PascalBilger/Twin-Io/Electronics/2024-03-01_Twin_Io.brd

## EAGLE design Electronics/2024-03-01_Twin_Io.brd (2024-03-18)

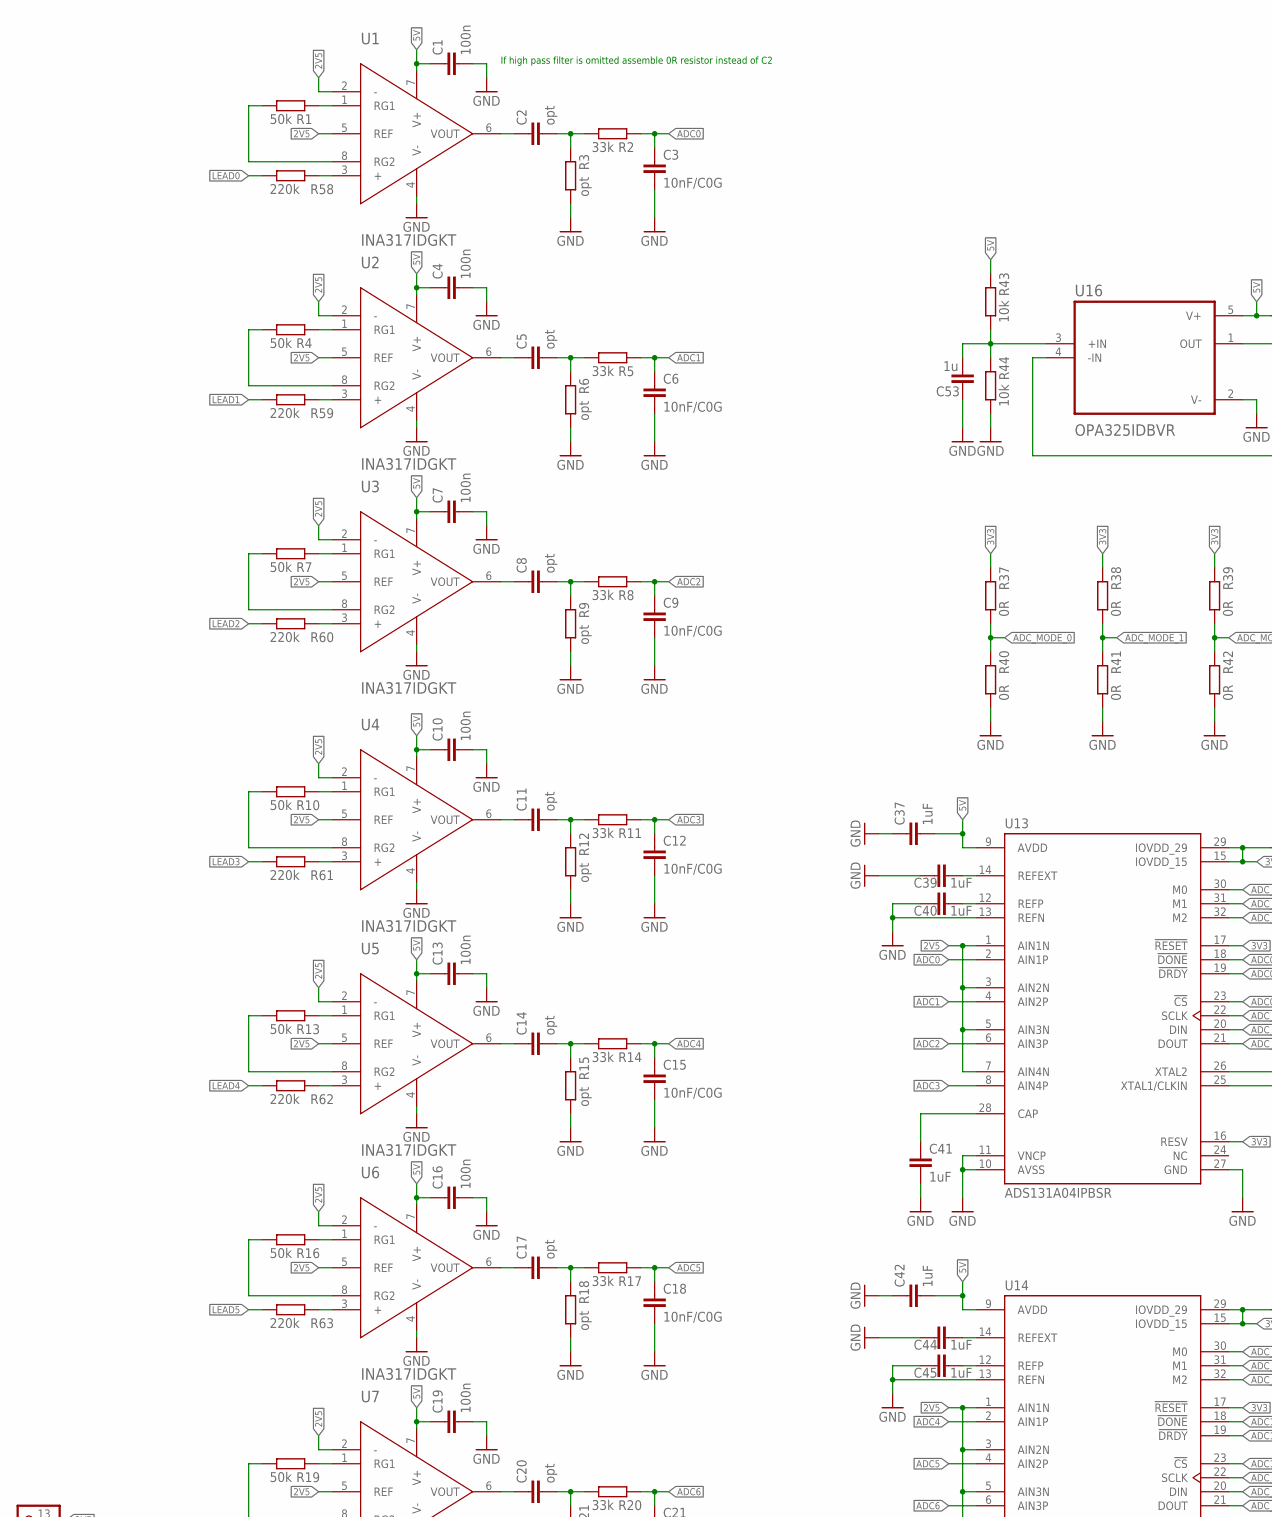
[picture p1: schematic 2024-03-01_Twin_Io.sch, part in row 1, column 1]

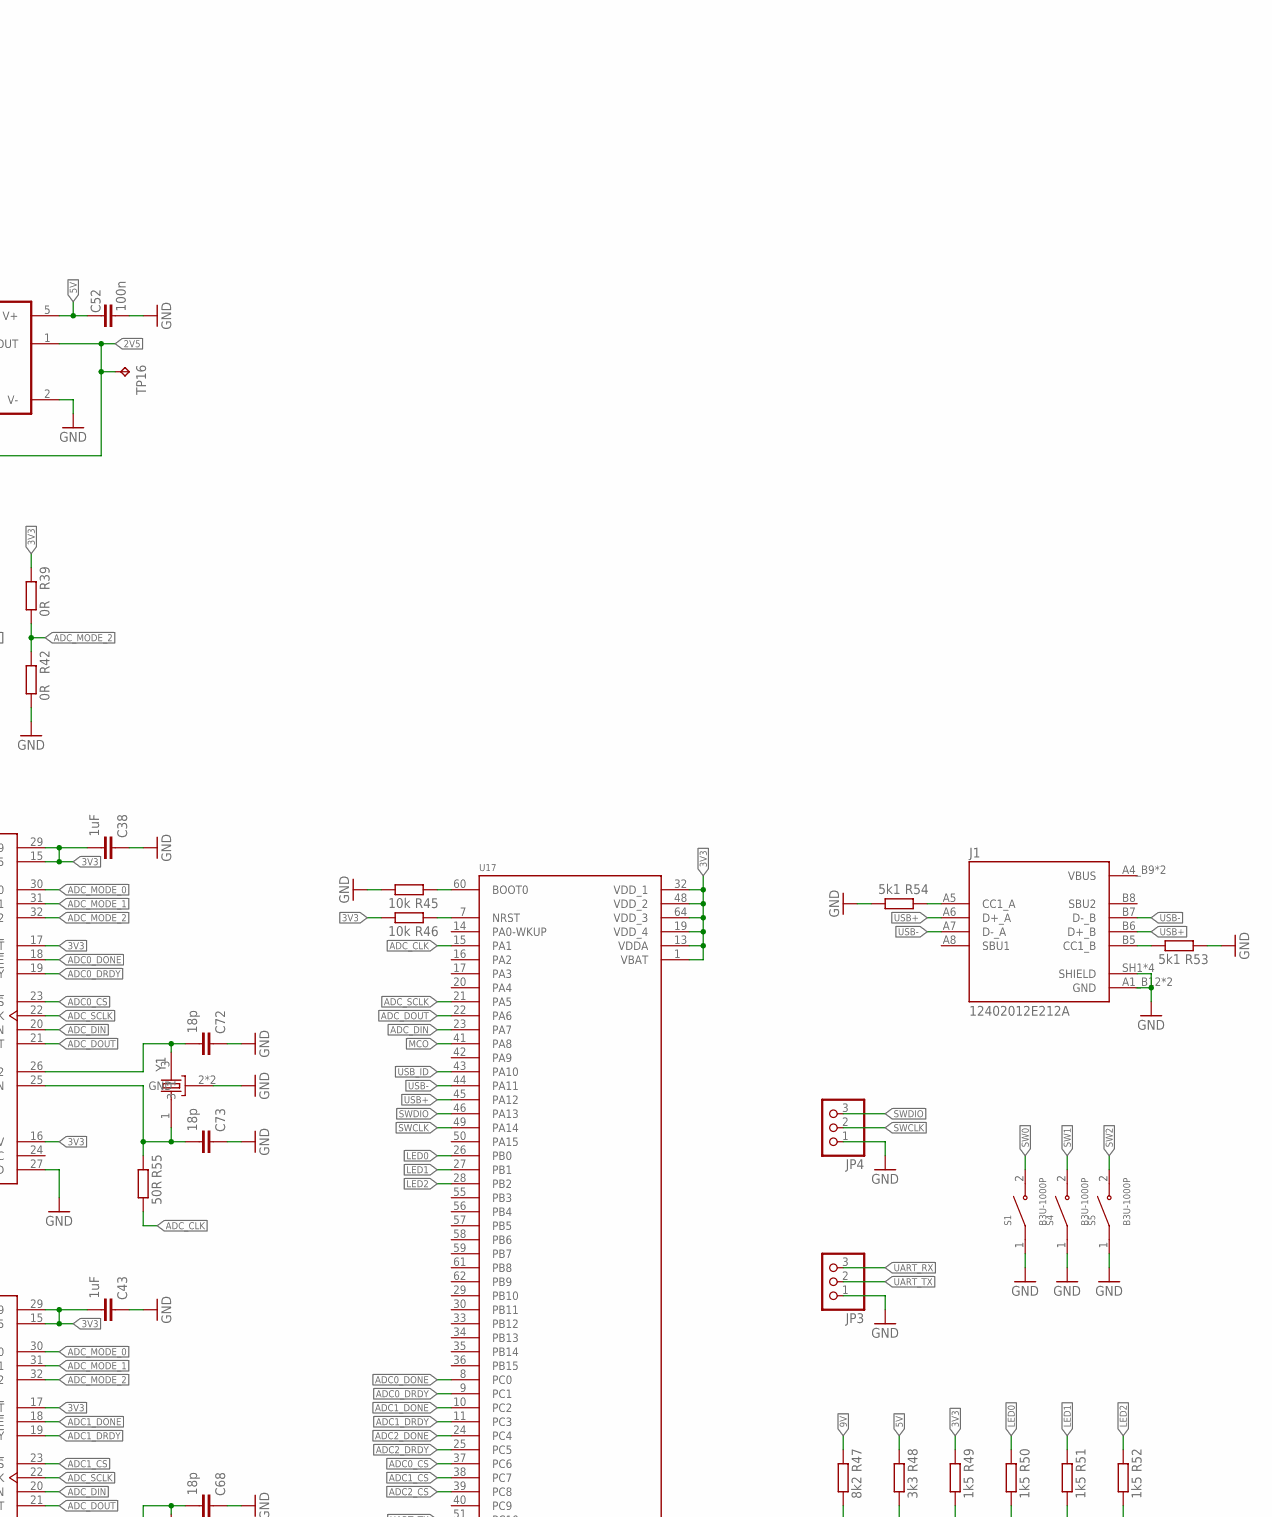
[picture p2: schematic 2024-03-01_Twin_Io.sch, part in row 1, column 2]

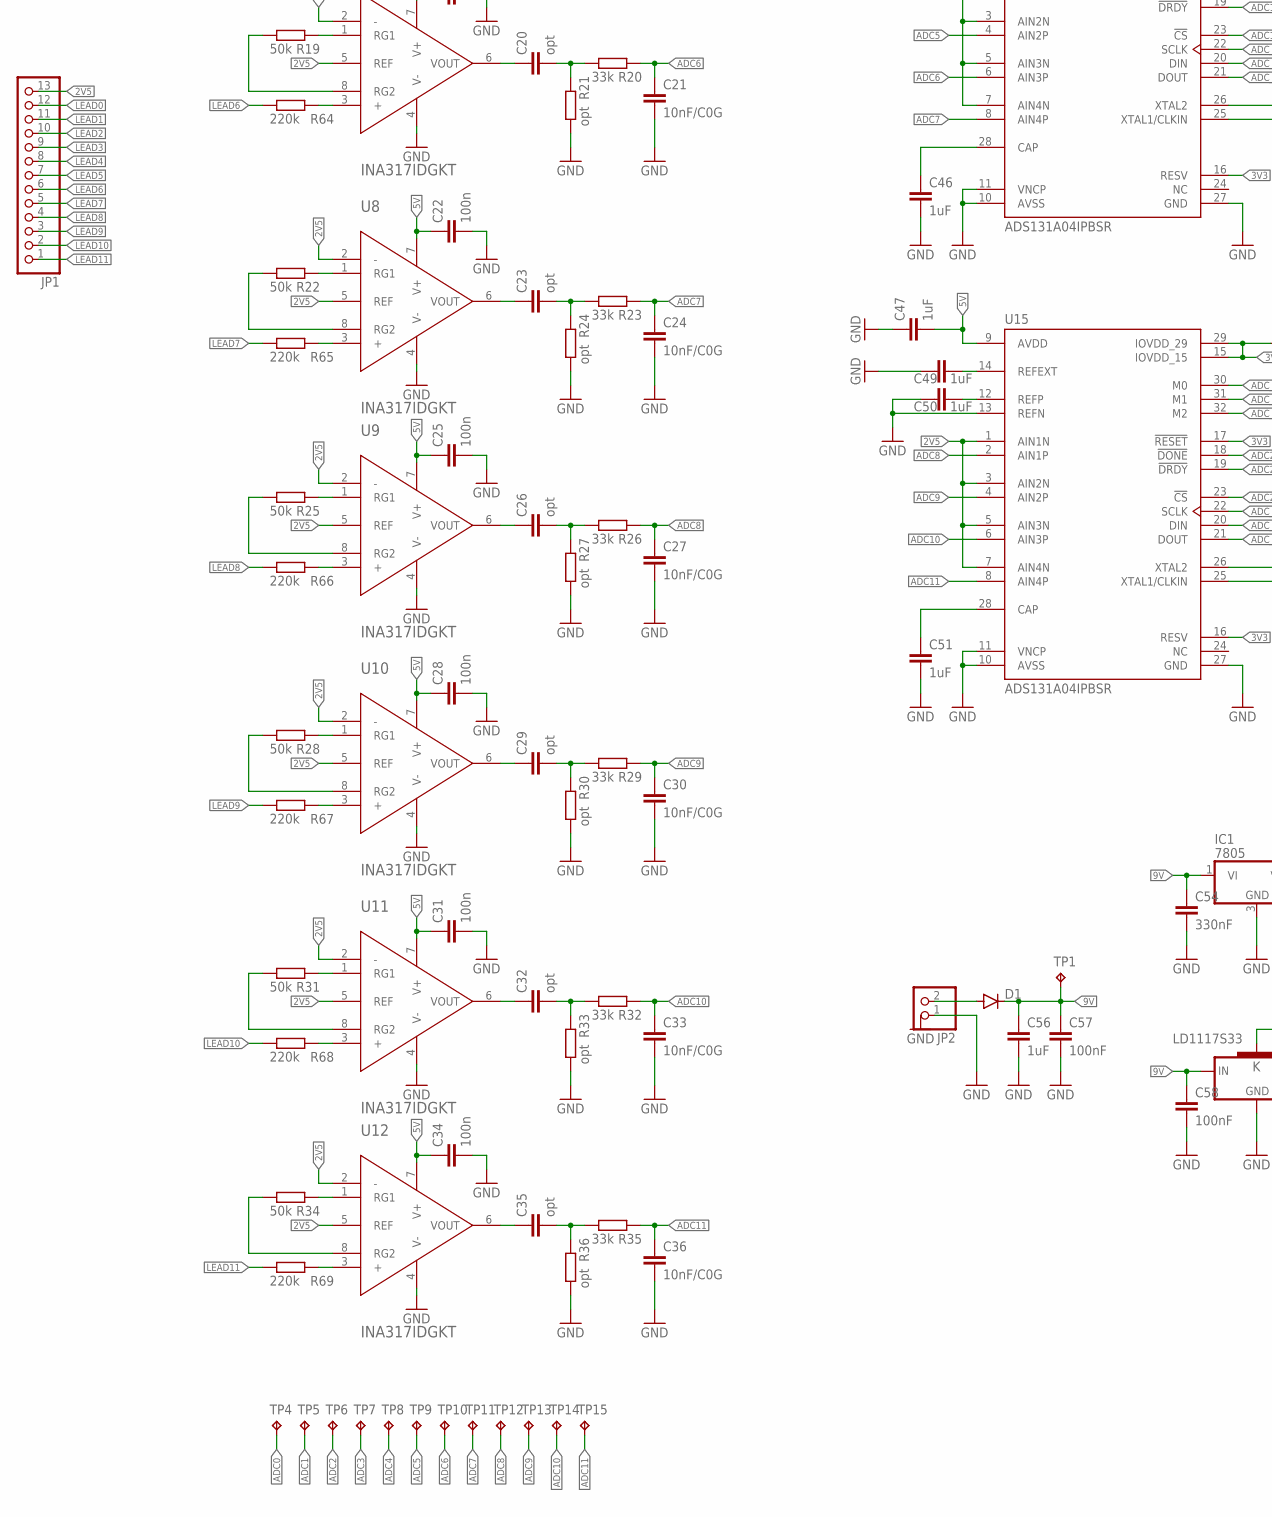
[picture p3: schematic 2024-03-01_Twin_Io.sch, part in row 2, column 1]

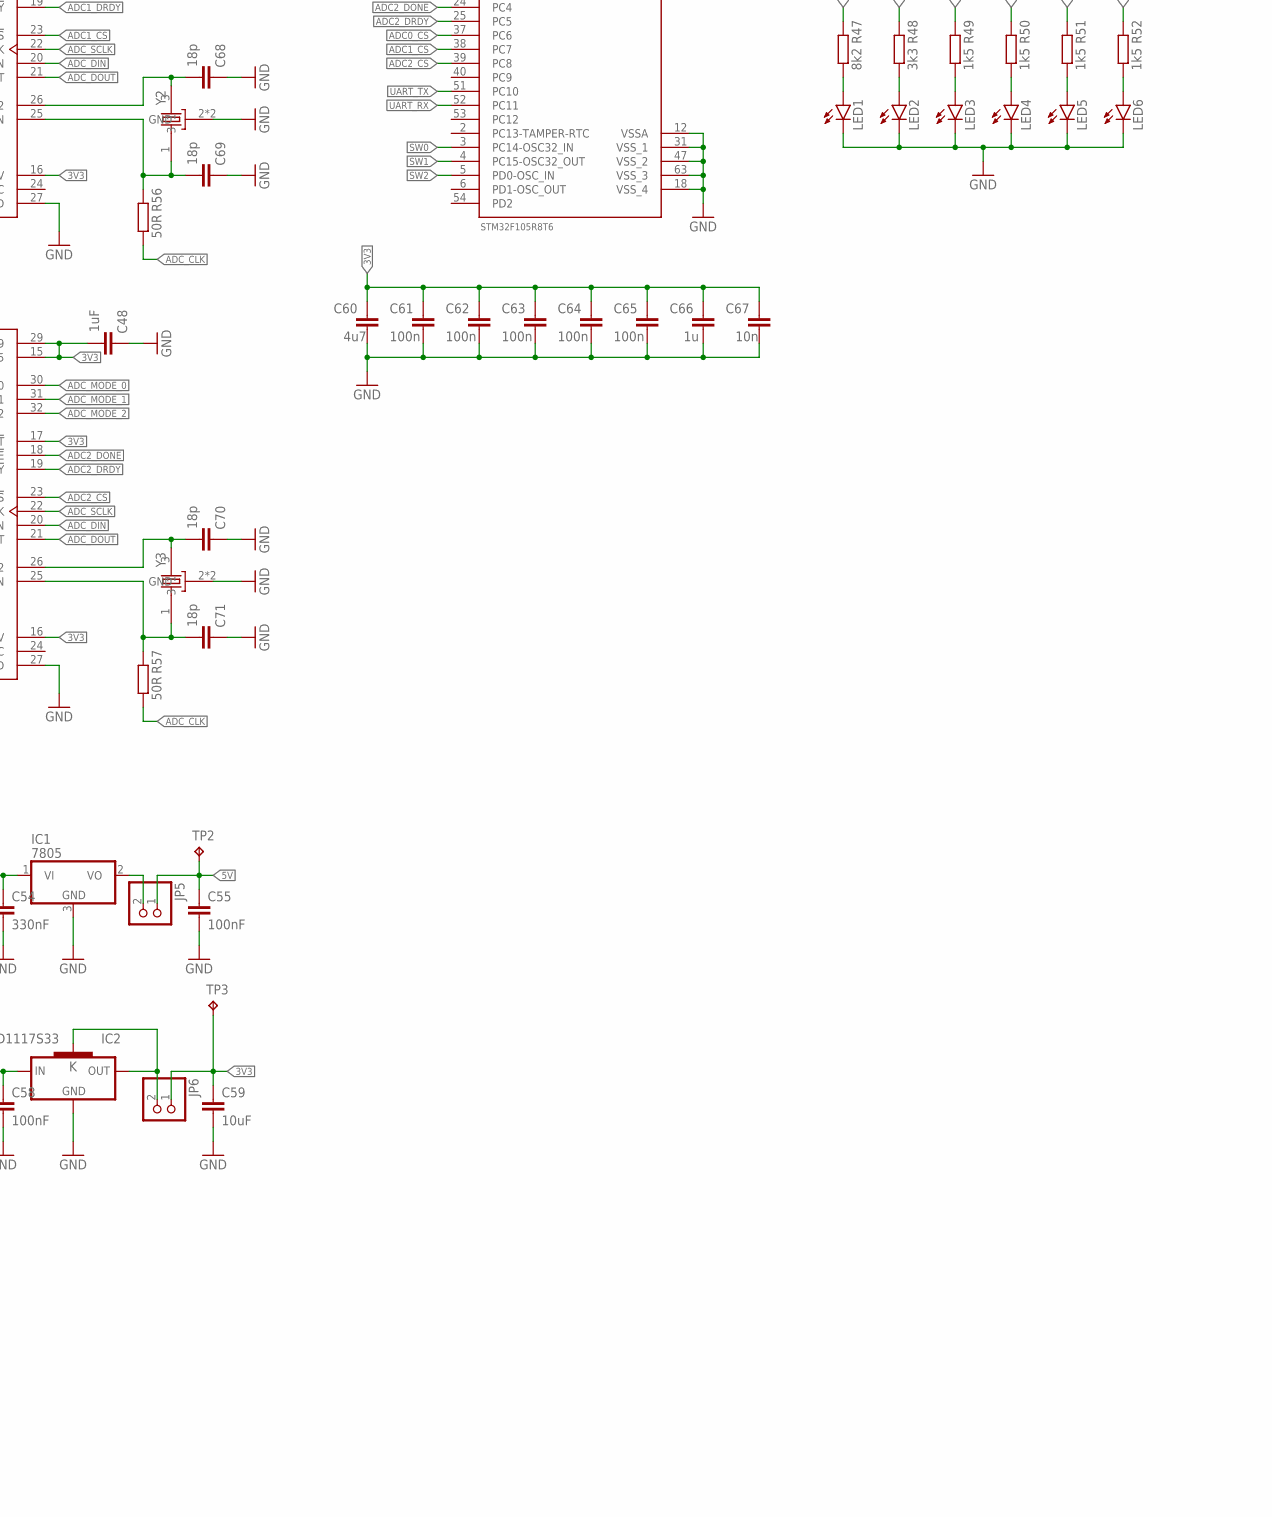
[picture p4: schematic 2024-03-01_Twin_Io.sch, part in row 2, column 2]

Parts:
C1, C4, C7, C10, C13, C16, C19, C22, C25, C28, C31, C34, C52, C61, C62, C63, C64, C65: 100n; C0603
C2, C5, C8, C11, C14, C17, C20, C23, C26, C29, C32, C35: opt; C0603
C3, C6, C9, C12, C15, C18, C21, C24, C27, C30, C33, C36: 10nF/C0G; C0603
C37, C38, C39, C40, C41, C42, C43, C44, C45, C46, C47, C48, C49, C50, C51, C56: 1uF; C0603
C53, C66: 1u; C0603
C54: 330nF; C0603
C55, C57, C58: 100nF; C0603
C59: 10uF; C0603
C60: 4u7; C0603
C67: 10n; C0603
C68, C69, C70, C71, C72, C73: 18p; C0603
D1: DIODE-DO214AA; DO214AA
IC1: 7805; TO252
IC2: LD1117S33; SOT223
J1: 12402012E212A; AMPHENOL_12402012E212A
JP1: PINHD-1X13; 1X13
JP2, JP5, JP6: PINHD-1X2; 1X02
JP3, JP4: PINHD-1X3; 1X03
LED1, LED2, LED3, LED4, LED5, LED6: LEDSML1206; SML1206
R1, R4, R7, R10, R13, R16, R19, R22, R25, R28, R31, R34: 50k; R0603
R2, R5, R8, R11, R14, R17, R20, R23, R26, R29, R32, R35: 33k; R0603
R3, R6, R9, R12, R15, R18, R21, R24, R27, R30, R33, R36: opt; R0603
R37, R38, R39, R40, R41, R42: 0R; R0603
R43, R44, R45, R46: 10k; R0603
R47: 8k2; R0603
R48: 3k3; R0603
R49, R50, R51, R52: 1k5; R0603
R53, R54: 5k1; R0603
R55, R56, R57: 50R; R0603
R58, R59, R60, R61, R62, R63, R64, R65, R66, R67, R68, R69: 220k; R0603
S1, S4, S5: B3U-1000P; SW_B3U-1000P
TP1, TP2, TP3, TP4, TP5, TP6, TP7, TP8, TP9, TP10, TP11, TP12, TP13, TP14, TP15, TP16: TPPAD1-17; P1-17
U1, U2, U3, U4, U5, U6, U7, U8, U9, U10, U11, U12: INA317IDGKT; SOP65P490X110-8N
U13, U14, U15: ADS131A04IPBSR; QFP50P700X700X120-32N
U16: OPA325IDBVR; SOT95P280X145-5N
U17: STM32F105R8T6; QFP50P1200X1200X160-64N
Y1, Y2, Y3: ABM3C-16.384MHZ-D4Y-T; OSCCC500X320X110-4N

Connections:
2V5: JP1.13, TP16.TP, U1.2 (-), U1.5 (REF), U2.2 (-), U2.5 (REF), U3.2 (-), U3.5 (REF), U4.2 (-), U4.5 (REF), U5.2 (-), U5.5 (REF), U6.2 (-), U6.5 (REF), U7.2 (-), U7.5 (REF), U8.2 (-), U8.5 (REF), U9.2 (-), U9.5 (REF), U10.2 (-), U10.5 (REF), U11.2 (-), U11.5 (REF), U12.2 (-), U12.5 (REF), U13.1 (AIN1N), U13.3 (AIN2N), U13.5 (AIN3N), U13.7 (AIN4N), U14.1 (AIN1N), U14.3 (AIN2N), U14.5 (AIN3N), U14.7 (AIN4N), U15.1 (AIN1N), U15.3 (AIN2N), U15.5 (AIN3N), U15.7 (AIN4N), U16.1 (OUT), U16.4 (-IN)
3V3: C38.2, C43.2, C48.2, C59.1, C60.1, C61.1, C62.1, C63.1, C64.1, C65.1, C66.1, C67.1, JP6.1, R37.2, R38.2, R39.2, R46.1, R49.2, TP3.TP, U13.15 (IOVDD_15), U13.16 (RESV), U13.17 (!RESET), U13.29 (IOVDD_29), U14.15 (IOVDD_15), U14.16 (RESV), U14.17 (!RESET), U14.29 (IOVDD_29), U15.15 (IOVDD_15), U15.16 (RESV), U15.17 (!RESET), U15.29 (IOVDD_29), U17.1 (VBAT), U17.13 (VDDA), U17.19 (VDD_4), U17.32 (VDD_1), U17.48 (VDD_2), U17.64 (VDD_3)
5V: C1.1, C4.1, C7.1, C10.1, C13.1, C16.1, C19.1, C22.1, C25.1, C28.1, C31.1, C34.1, C37.2, C42.2, C47.2, C52.1, C55.1, JP5.1, R43.2, R48.2, TP2.TP, U1.7 (V+), U2.7 (V+), U3.7 (V+), U4.7 (V+), U5.7 (V+), U6.7 (V+), U7.7 (V+), U8.7 (V+), U9.7 (V+), U10.7 (V+), U11.7 (V+), U12.7 (V+), U13.9 (AVDD), U14.9 (AVDD), U15.9 (AVDD), U16.5 (V+)
9V: C54.1, C56.1, C57.1, C58.1, D1.C, IC1.1 (VI), IC2.3 (IN), R47.2, TP1.TP
ADC0: C3.1, R2.2, TP4.TP, U13.2 (AIN1P)
ADC0_CS: U13.23 (!CS), U17.37 (PC6)
ADC0_DONE: U13.18 (!DONE), U17.8 (PC0)
ADC0_DRDY: U13.19 (!DRDY), U17.9 (PC1)
ADC1: C6.1, R5.2, TP5.TP, U13.4 (AIN2P)
ADC1_CS: U14.23 (!CS), U17.38 (PC7)
ADC1_DONE: U14.18 (!DONE), U17.10 (PC2)
ADC1_DRDY: U14.19 (!DRDY), U17.11 (PC3)
ADC2: C9.1, R8.2, TP6.TP, U13.6 (AIN3P)
ADC2_CS: U15.23 (!CS), U17.39 (PC8)
ADC2_DONE: U15.18 (!DONE), U17.24 (PC4)
ADC2_DRDY: U15.19 (!DRDY), U17.25 (PC5)
ADC3: C12.1, R11.2, TP7.TP, U13.8 (AIN4P)
ADC4: C15.1, R14.2, TP8.TP, U14.2 (AIN1P)
ADC5: C18.1, R17.2, TP9.TP, U14.4 (AIN2P)
ADC6: C21.1, R20.2, TP10.TP, U14.6 (AIN3P)
ADC7: C24.1, R23.2, TP11.TP, U14.8 (AIN4P)
ADC8: C27.1, R26.2, TP12.TP, U15.2 (AIN1P)
ADC9: C30.1, R29.2, TP13.TP, U15.4 (AIN2P)
ADC10: C33.1, R32.2, TP14.TP, U15.6 (AIN3P)
ADC11: C36.1, R35.2, TP15.TP, U15.8 (AIN4P)
ADC_CLK: R55.1, R56.1, R57.1, U17.15 (PA1)
ADC_DIN: U13.20 (DIN), U14.20 (DIN), U15.20 (DIN), U17.23 (PA7)
ADC_DOUT: U13.21 (DOUT), U14.21 (DOUT), U15.21 (DOUT), U17.22 (PA6)
ADC_MODE_0: R37.1, R40.2, U13.30 (M0), U14.30 (M0), U15.30 (M0)
ADC_MODE_1: R38.1, R41.2, U13.31 (M1), U14.31 (M1), U15.31 (M1)
ADC_MODE_2: R39.1, R42.2, U13.32 (M2), U14.32 (M2), U15.32 (M2)
ADC_SCLK: U13.22 (SCLK), U14.22 (SCLK), U15.22 (SCLK), U17.21 (PA5)
GND: C1.2, C3.2, C4.2, C6.2, C7.2, C9.2, C10.2, C12.2, C13.2, C15.2, C16.2, C18.2, C19.2, C21.2, C22.2, C24.2, C25.2, C27.2, C28.2, C30.2, C31.2, C33.2, C34.2, C36.2, C37.1, C38.1, C39.1, C40.1, C41.2, C42.1, C43.1, C44.1, C45.1, C46.2, C47.1, C48.1, C49.1, C50.1, C51.2, C52.2, C53.1, C54.2, C55.2, C56.2, C57.2, C58.2, C59.2, C60.2, C61.2, C62.2, C63.2, C64.2, C65.2, C66.2, C67.2, C68.1, C69.1, C70.1, C71.1, C72.1, C73.1, IC1.3 (GND), IC2.1 (GND), J1.A1_B12 (GND), J1.B1_A12 (GND), J1.SH1 (SHIELD), J1.SH2 (SHIELD), J1.SH3 (SHIELD), J1.SH4 (SHIELD), JP2.1, JP3.1, JP4.1, LED1.C, LED2.C, LED3.C, LED4.C, LED5.C, LED6.C, R3.1, R6.1, R9.1, R12.1, R15.1, R18.1, R21.1, R24.1, R27.1, R30.1, R33.1, R36.1, R40.1, R41.1, R42.1, R44.1, R45.1, R53.2, R54.1, S1.1, S4.1, S5.1, U1.4 (V-), U2.4 (V-), U3.4 (V-), U4.4 (V-), U5.4 (V-), U6.4 (V-), U7.4 (V-), U8.4 (V-), U9.4 (V-), U10.4 (V-), U11.4 (V-), U12.4 (V-), U13.10 (AVSS), U13.11 (VNCP), U13.13 (REFN), U13.27 (GND), U14.10 (AVSS), U14.11 (VNCP), U14.13 (REFN), U14.27 (GND), U15.10 (AVSS), U15.11 (VNCP), U15.13 (REFN), U15.27 (GND), U16.2 (V-), U17.12 (VSSA), U17.18 (VSS_4), U17.31 (VSS_1), U17.47 (VSS_2), U17.63 (VSS_3), Y1.2 (GND), Y1.4 (GND), Y2.2 (GND), Y2.4 (GND), Y3.2 (GND), Y3.4 (GND)
LEAD0: JP1.12, R58.1
LEAD1: JP1.11, R59.1
LEAD2: JP1.10, R60.1
LEAD3: JP1.9, R61.1
LEAD4: JP1.8, R62.1
LEAD5: JP1.7, R63.1
LEAD6: JP1.6, R64.1
LEAD7: JP1.5, R65.1
LEAD8: JP1.4, R66.1
LEAD9: JP1.3, R67.1
LEAD10: JP1.2, R68.1
LEAD11: JP1.1, R69.1
LED0: R50.2, U17.26 (PB0)
LED1: R51.2, U17.27 (PB1)
LED2: R52.2, U17.28 (PB2)
MCO: U17.41 (PA8)
unnamed: R1.2, U1.1 (RG1)
unnamed: R1.1, U1.8 (RG2)
unnamed: C2.1, U1.6 (VOUT)
unnamed: C2.2, R2.1, R3.2
unnamed: D1.A, JP2.2
unnamed: C41.1, U13.28 (CAP)
unnamed: C72.2, U13.26 (XTAL2), Y1.3
unnamed: C73.2, R55.2, U13.25 (XTAL1/CLKIN), Y1.1
unnamed: C40.2, U13.12 (REFP)
unnamed: C39.2, U13.14 (REFEXT)
unnamed: R4.2, U2.1 (RG1)
unnamed: R4.1, U2.8 (RG2)
unnamed: C5.1, U2.6 (VOUT)
unnamed: C5.2, R5.1, R6.2
unnamed: R7.2, U3.1 (RG1)
unnamed: R7.1, U3.8 (RG2)
unnamed: C8.1, U3.6 (VOUT)
unnamed: C8.2, R8.1, R9.2
unnamed: R10.2, U4.1 (RG1)
unnamed: R10.1, U4.8 (RG2)
unnamed: C11.1, U4.6 (VOUT)
unnamed: C11.2, R11.1, R12.2
unnamed: R13.2, U5.1 (RG1)
unnamed: R13.1, U5.8 (RG2)
unnamed: C14.1, U5.6 (VOUT)
unnamed: C14.2, R14.1, R15.2
unnamed: R16.2, U6.1 (RG1)
unnamed: R16.1, U6.8 (RG2)
unnamed: C17.1, U6.6 (VOUT)
unnamed: C17.2, R17.1, R18.2
unnamed: R19.2, U7.1 (RG1)
unnamed: R19.1, U7.8 (RG2)
unnamed: C20.1, U7.6 (VOUT)
unnamed: C20.2, R20.1, R21.2
unnamed: R22.2, U8.1 (RG1)
unnamed: R22.1, U8.8 (RG2)
unnamed: C23.1, U8.6 (VOUT)
unnamed: C23.2, R23.1, R24.2
unnamed: R25.2, U9.1 (RG1)
unnamed: R25.1, U9.8 (RG2)
unnamed: C26.1, U9.6 (VOUT)
unnamed: C26.2, R26.1, R27.2
unnamed: C69.2, R56.2, U14.25 (XTAL1/CLKIN), Y2.1
unnamed: C46.1, U14.28 (CAP)
unnamed: C44.2, U14.14 (REFEXT)
unnamed: C68.2, U14.26 (XTAL2), Y2.3
unnamed: C45.2, U14.12 (REFP)
unnamed: C70.2, U15.26 (XTAL2), Y3.3
unnamed: C51.1, U15.28 (CAP)
unnamed: C49.2, U15.14 (REFEXT)
unnamed: C71.2, R57.2, U15.25 (XTAL1/CLKIN), Y3.1
unnamed: C50.2, U15.12 (REFP)
unnamed: R28.2, U10.1 (RG1)
unnamed: R28.1, U10.8 (RG2)
unnamed: C29.1, U10.6 (VOUT)
unnamed: C29.2, R29.1, R30.2
unnamed: R31.2, U11.1 (RG1)
unnamed: R31.1, U11.8 (RG2)
unnamed: C32.1, U11.6 (VOUT)
unnamed: C32.2, R32.1, R33.2
unnamed: R34.2, U12.1 (RG1)
unnamed: R34.1, U12.8 (RG2)
unnamed: C35.1, U12.6 (VOUT)
unnamed: C35.2, R35.1, R36.2
unnamed: R45.2, U17.60 (BOOT0)
unnamed: R46.2, U17.7 (NRST)
unnamed: C53.2, R43.1, R44.2, U16.3 (+IN)
unnamed: LED1.A, R47.1
unnamed: LED2.A, R48.1
unnamed: LED3.A, R49.1
unnamed: LED4.A, R50.1
unnamed: LED5.A, R51.1
unnamed: LED6.A, R52.1
unnamed: J1.A5 (CC1_A), R54.2
unnamed: J1.B5 (CC1_B), R53.1
unnamed: IC1.2 (VO), JP5.2
unnamed: R58.2, U1.3 (+)
unnamed: IC2.2 (OUT), IC2.4 (K), JP6.2
unnamed: R59.2, U2.3 (+)
unnamed: R60.2, U3.3 (+)
unnamed: R61.2, U4.3 (+)
unnamed: R62.2, U5.3 (+)
unnamed: R63.2, U6.3 (+)
unnamed: R64.2, U7.3 (+)
unnamed: R65.2, U8.3 (+)
unnamed: R66.2, U9.3 (+)
unnamed: R67.2, U10.3 (+)
unnamed: R68.2, U11.3 (+)
unnamed: R69.2, U12.3 (+)
SW0: S1.2, U17.3 (PC14-OSC32_IN)
SW1: S4.2, U17.4 (PC15-OSC32_OUT)
SW2: S5.2, U17.5 (PD0-OSC_IN)
SWCLK: JP4.2, U17.49 (PA14)
SWDIO: JP4.3, U17.46 (PA13)
UART_RX: JP3.3, U17.52 (PC11)
UART_TX: JP3.2, U17.51 (PC10)
USB+: J1.A6 (D+_A), J1.B6 (D+_B), U17.45 (PA12)
USB-: J1.A7 (D-_A), J1.B7 (D-_B), U17.44 (PA11)
USB_ID: U17.43 (PA10)
VBUS: J1.A4_B9 (VBUS), J1.B4_A9 (VBUS)

Notes on the sheet:
If high pass filter is omitted assemble 0R resistor instead of C2

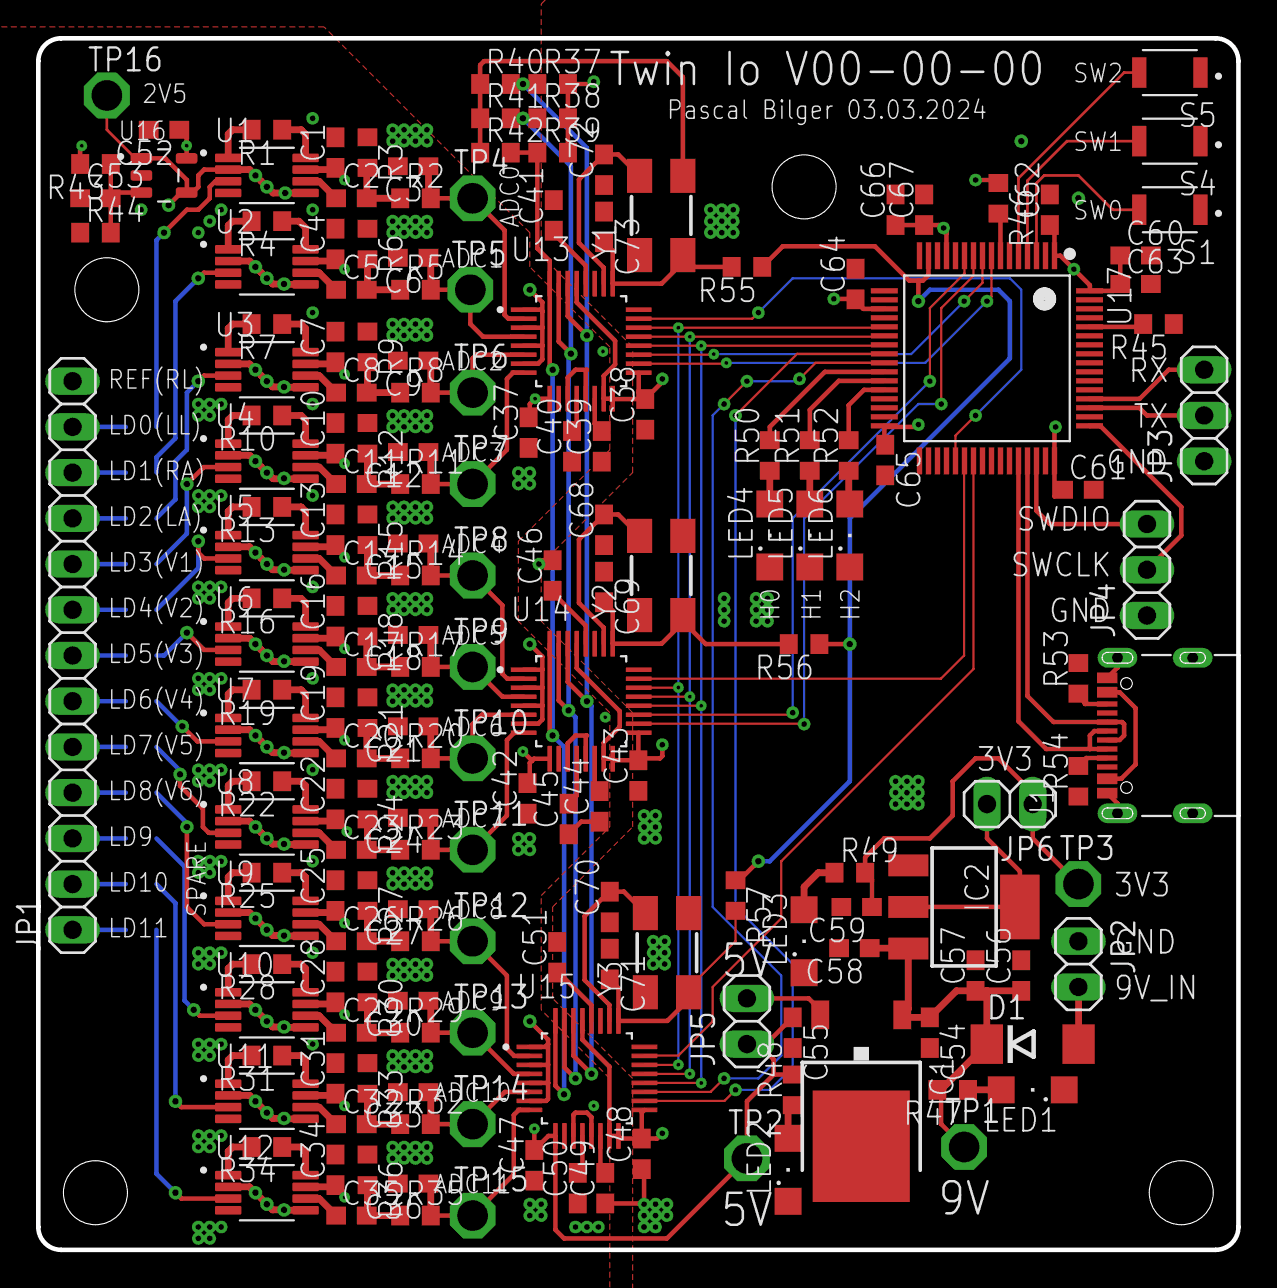
[picture p5: board 2024-03-01_Twin_Io.brd from above]

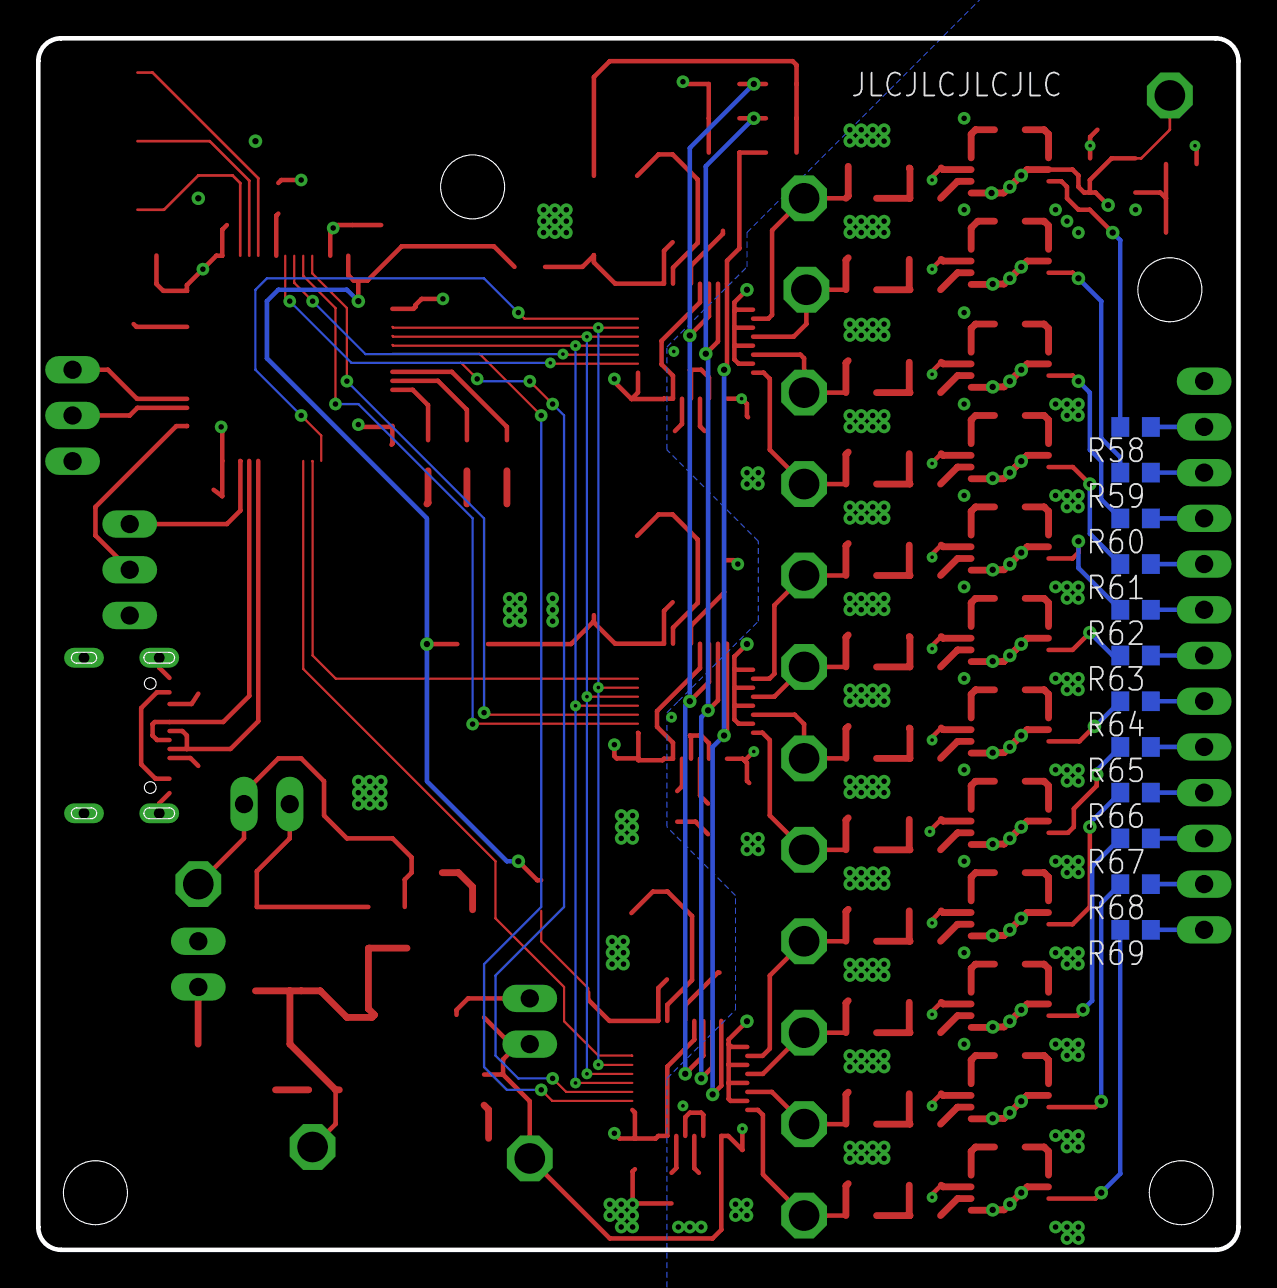
[picture p6: board 2024-03-01_Twin_Io.brd from below]

Board: 4 copper layers, 66.7 x 67.3 mm, 197 parts (12 on the bottom side), 147 nets.
