PascalBilger/Twin-Io/Firmware/Prototype/Twin_Io/Twin_Io.ioc

Mcu.UserName=STM32F105R8Tx
PA1.Signal=S_TIM2_CH2
PA10.Signal=USART1_RX
PA13.Signal=SYS_JTMS-SWDIO
PA14.Signal=SYS_JTCK-SWCLK
PA5.Signal=SPI1_SCK
PA6.Signal=SPI1_MISO
PA7.Signal=SPI1_MOSI
PA9.Signal=USART1_TX
PB0.GPIO_Label=LED0
PB0.Signal=GPIO_Output
PB1.GPIO_Label=LED1
PB1.Signal=GPIO_Output
PB2.GPIO_Label=LED2
PB2.Signal=GPIO_Output
PC0.GPIO_Label=ADC0_DONE
PC0.Signal=GPIO_Input
PC1.GPIO_Label=ADC0_DRDY
PC1.Signal=GPXTI1
PC10.Signal=USART3_TX
PC11.Signal=USART3_RX
PC14-OSC32_IN.GPIO_Label=SW0
PC14-OSC32_IN.Signal=GPIO_Input
PC15-OSC32_OUT.GPIO_Label=SW1
PC15-OSC32_OUT.Signal=GPIO_Input
PC2.GPIO_Label=ADC1_DONE
PC2.Signal=GPIO_Input
PC3.GPIO_Label=ADC1_DRDY
PC3.Signal=GPXTI3
PC4.GPIO_Label=ADC2_DONE
PC4.Signal=GPIO_Input
PC5.GPIO_Label=ADC2_DRDY
PC5.Signal=GPXTI5
PC6.GPIO_Label=ADC0_CS
PC6.Signal=GPIO_Output
PC7.GPIO_Label=ADC1_CS
PC7.Signal=GPIO_Output
PC8.GPIO_Label=ADC2_CS
PC8.Signal=GPIO_Output
PD0-OSC_IN.Signal=RCC_OSC_IN
PD1-OSC_OUT.Signal=RCC_OSC_OUT
