PascalBilger/Twin-Io/(commit log)

2024-03-02 Added first version of schematic
    [2023-03-01_Twin_Io_Schematic.sch]
2024-03-02 renamed all components and created board
    [2023-03-01_Twin_Io_Schematic.brd, 2023-03-01_Twin_Io_Schematic.sch]
2024-03-03 First Prototype Version of Schematic and PCB done
    [2023-03-01_Twin_Io_Schematic.brd, 2023-03-01_Twin_Io_Schematic.sch]
2024-03-04 Renamed Schematic and Board with correct Year
    [2024-03-01_Twin_Io_Schematic.brd, 2024-03-01_Twin_Io_Schematic.sch]
2024-03-04 Created an adapter from AD8422 to INA317
    [2024-03-04_AD4882-to-INA317-Adapter.brd, 2024-03-04_AD4882-to-INA317-Adapter.sch]
2024-03-05 Added possibility for STM32 Timer output to be used for the ADC clock, selectable by 3x 0Ohm resistors
    [2024-03-01_Twin_Io_Schematic.brd, 2024-03-01_Twin_Io_Schematic.sch]
2024-03-06 Final changes for V00-00-00
    [2024-03-01_Twin_Io.brd, 2024-03-01_Twin_Io.sch, 2024-03-04_AD4882-to-INA317-Adapter.brd, 2024-03-04_AD4882-to-INA317-Adapter.sch]
2024-03-16 Wrote a python program which extracts Channel 0 from ADC readings
2024-03-18 RawToCsv working for 12 Channels including filtering
2024-03-18 LiveView working with filtering for all 12 ADC channels
2024-03-18 Changed the compiler optimization from none to fast Code is now able to read the ADC at 2kHz and send it via 3MBaud to Serial. Attention: There is a bug which was not further investigated which mirro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
    [Twin_Io.ioc]
2024-03-18 Changed the Resistors which connect the STM32 to the clock input of the ADC from 0R to 50R
    [2024-03-01_Twin_Io.brd, 2024-03-01_Twin_Io.sch]
2024-03-18 Added pdf files of schematic and layout of the first prototype
2024-03-19 Added all of the files which are auto generated by STM32CubeIDE to .gitignore
2024-03-19 Added files for STM32CubeIDE which are needed to compile the program. They were removed earlier because I thought they werent needed
2024-03-22 Lowered the SPI Baudrate from 16.384 to 4.096MBits/s which solved the problem with mirrored channels and general weird behavior. Caution: A Baudrate of 8.192MBits/s was also tested but resulted in th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
    [Twin_Io.ioc]
2024-03-23 - Added the option to LiveView to scale all graphs at the same time to analyze the data - Added calculation of the lead voltages from the electrodes - Added dc-offset removal - Added conversion from 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
2024-03-23 Fixed a bug. The configuration of the ADS131 which should have gone into register 0xC was written into register 0xB which resulted in the ADCs going into "power save" instead of "high resolution" mod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
    [main.c]
2024-03-23 - Added a counter to display the current progress with analyzing the data - Fixed a bug which caused the time on the graph to always be from 0-10 seconds - Inverted how "AutoScaleYAxis" affects the b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
    [LiveView.py]
